bay-zoltan-nonprofit-ltd/baybit-hardware/photos/baybit_photo_2.jpg

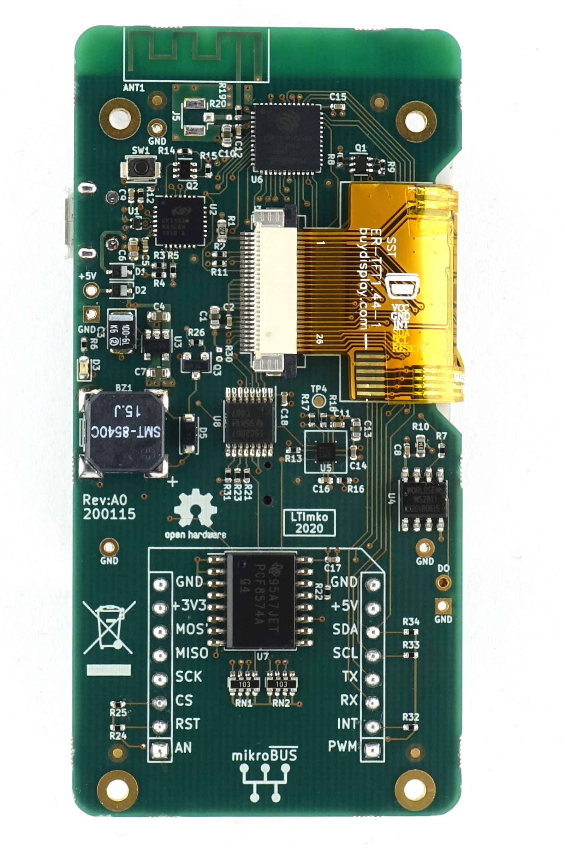
photos/baybit_photo_2.jpg
