bay-zoltan-nonprofit-ltd/baybit-hardware/photos/baybit_photo_1.jpg

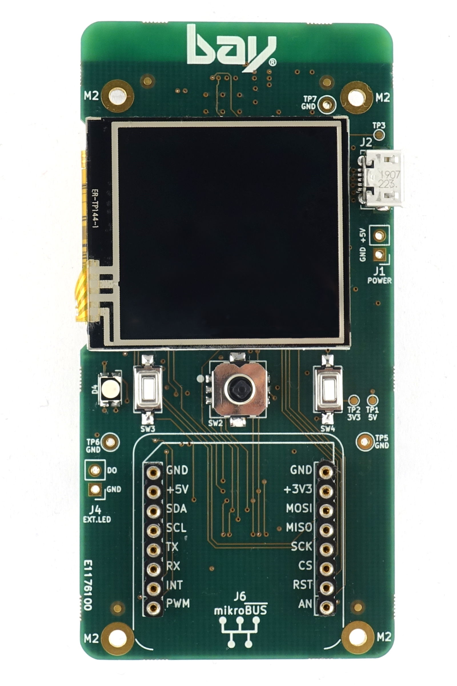
photos/baybit_photo_1.jpg
