bay-zoltan-nonprofit-ltd/baybit-hardware/fab/pcb/readme.txt

PCB Specifications:
  Layers: 4
  Board size: 42 x 85mm
  Board thickness: 1.5mm
  Smallest line width: 0.15mm (6mil)
  Smallest VIA: 0.65mm pad / 0.3mm hole (ipc7351b: v65h30)
  
Layer stack-up:
  LAYER1 - Front - SIGNAL
  LAYER2 - In1 - PLANE
  LAYER3 - In2 - PLANE
  LAYER4 - Back - SIGNAL
