bay-zoltan-nonprofit-ltd/baybit-hardware/photos/baybit_render_3d.jpg

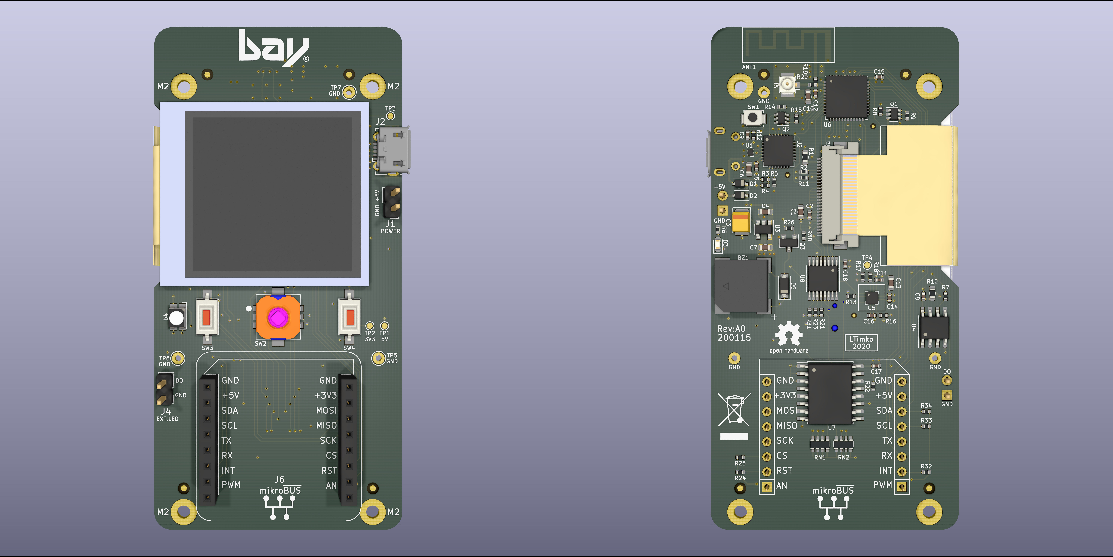
photos/baybit_render_3d.jpg
