bay-zoltan-nonprofit-ltd/baybit-hardware/design/3dmodels/ASMB-MTB0-0A3A2.STEP

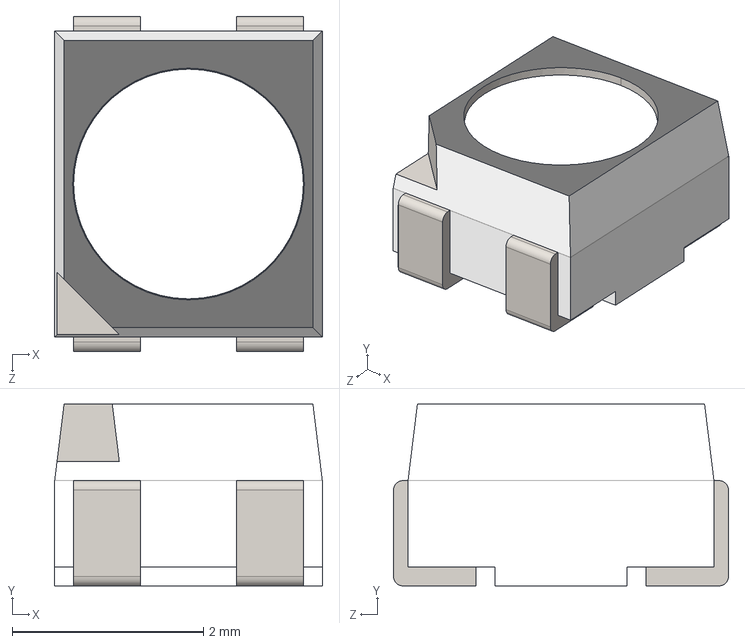
[picture p6: CAD file, 2020-03-06]
design/3dmodels/ASMB-MTB0-0A3A2.STEP
2.80 x 1.90 x 3.50 mm
