bay-zoltan-nonprofit-ltd/baybit-hardware/design/3dmodels/ER-TFT1.44-1.stp

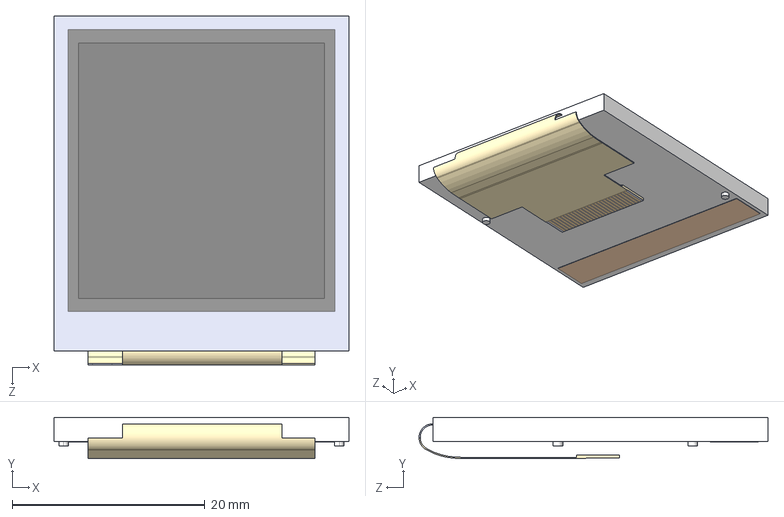
[picture p7: CAD file, 2020-03-06]
design/3dmodels/ER-TFT1.44-1.stp
30.6 x 4.29 x 36.2 mm
