bay-zoltan-nonprofit-ltd/baybit-hardware/design/3dmodels/FH12A-26S-0.5SH.stp

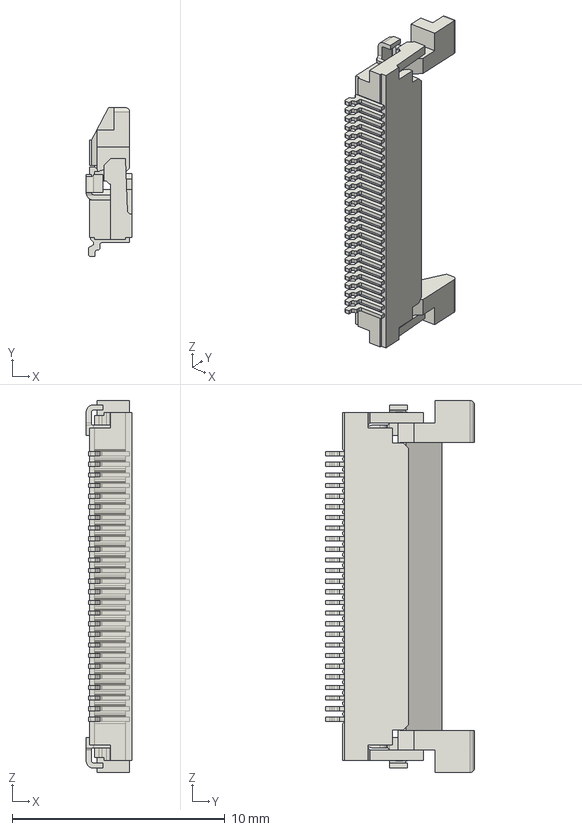
[picture p8: CAD file, 2020-03-06]
design/3dmodels/FH12A-26S-0.5SH.stp
2.15 x 7.00 x 17.5 mm
