bay-zoltan-nonprofit-ltd/baybit-hardware/design/3dmodels/SKRHAB.STEP

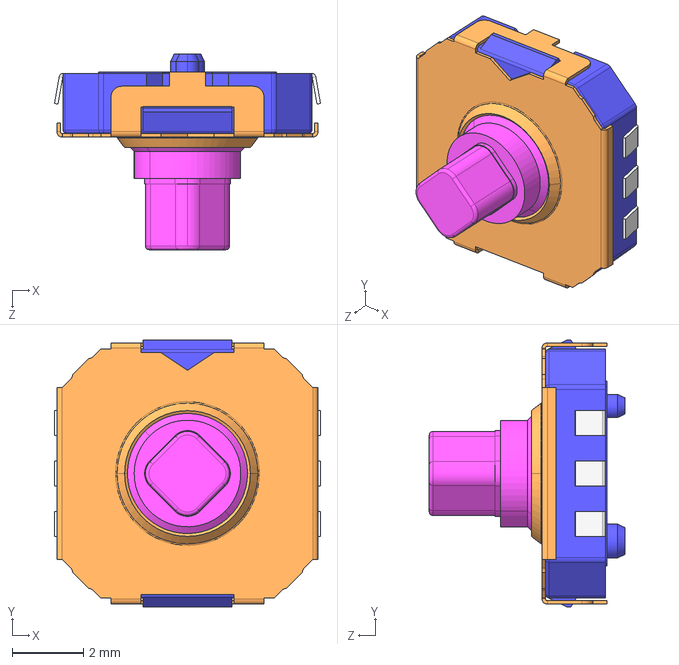
[picture p9: CAD file, 2020-03-06]
design/3dmodels/SKRHAB.STEP
7.48 x 7.50 x 5.50 mm
