bay-zoltan-nonprofit-ltd/baybit-hardware/design/3dmodels/BUZZER_SMT_85X85X32.step

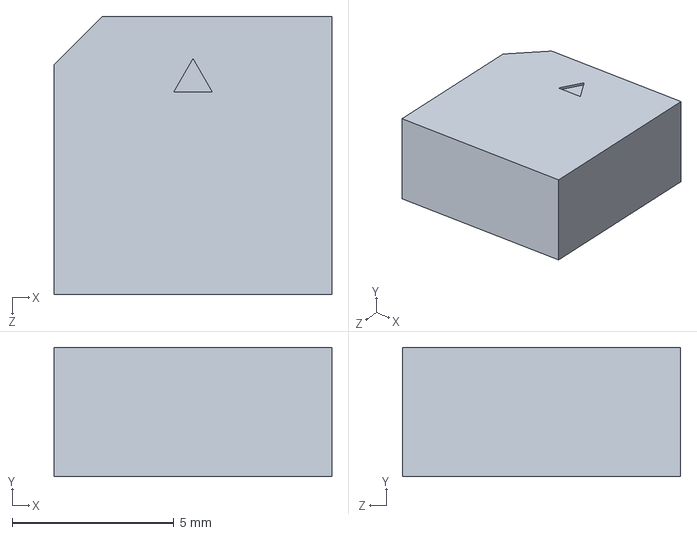
[picture p10: CAD file, 2020-03-06]
design/3dmodels/BUZZER_SMT_85X85X32.step
8.60 x 4.00 x 8.60 mm
