bay-zoltan-nonprofit-ltd/baybit-hardware/design/3dmodels/1050170001.stp

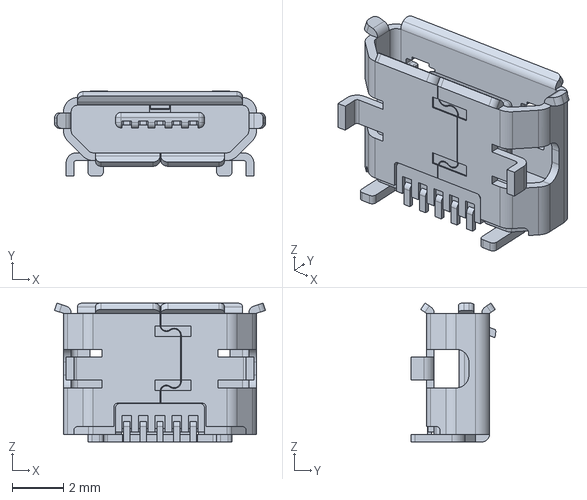
[picture p11: CAD file, 2020-03-06]
design/3dmodels/1050170001.stp
8.20 x 3.30 x 5.40 mm
