bay-zoltan-nonprofit-ltd/baybit-hardware/docs/baybit_schematic.pdf

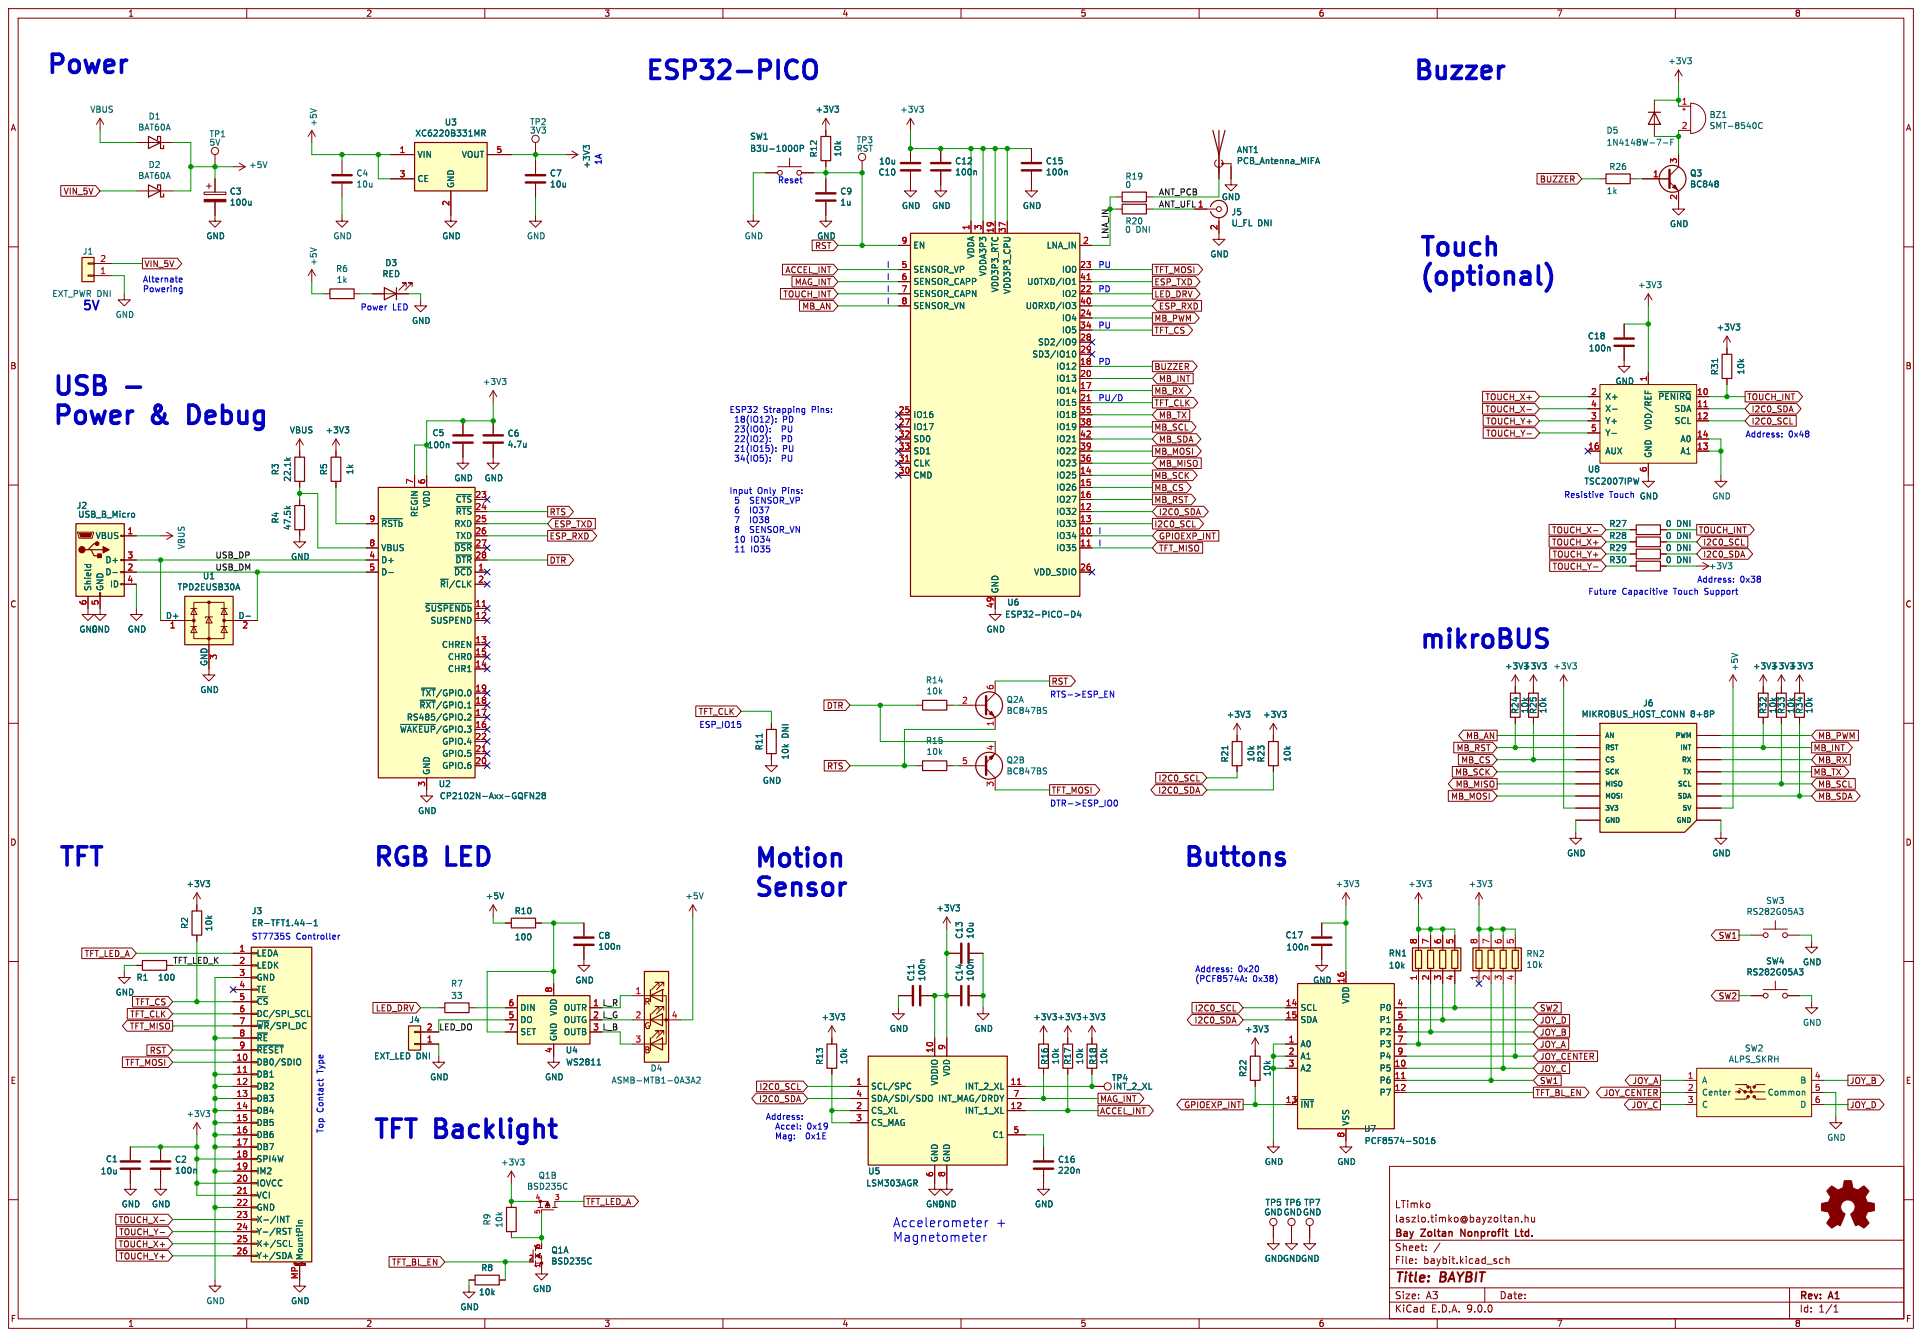
[picture p12: page 1]

4 OUTR 1 OUTG 2 OUTB 3 U4WS2811 GND R12 10k C10

Address: 0x48 PU TFT Backlight

3 ~{CTS} 23 ~{RTS} 24 RXD 25 TXD 26 ~{DSR} 27 ~{DTR} 28 ~{DCD}1 ~{RI}/CLK2 ~{SUSPENDb}11 SUSPEND 12 CHREN 13 CHR0 15 CHR1 14 ~{TXT}/GPIO.019 ~{RXT}/GPIO.118 RS485/GPIO.2 17 ~{WAKEUP}/GPIO.316 GPIO.4 22 GPIO.5 21 GPIO.6 20 C6

3 ~{CTS} 23 ~{RTS} 24 RXD 25 TXD 26 ~{DSR} 27 ~{DTR} 28 ~{DCD}1 ~{RI}/CLK2 ~{SUSPENDb}11 SUSPEND 12 CHREN 13 CHR0 15 CHR1 14 ~{TXT}/GPIO.019 ~{RXT}/GPIO.118 RS485/GPIO.2 17 ~{WAKEUP}/GPIO.316 GPIO.4 22 GPIO.5 21 GPIO.6 20 U2CP2102N-Axx-GQFN28

RTS->ESP_EN Top Contact Type

RST CS
SCK MISO MOSI 3V3 GND

4 OUTR 1 OUTG 2 OUTB 3 GND

laszlo.timko@bayzoltan.hu
