bay-zoltan-nonprofit-ltd/baybit-hardware/fab/assy/baybit_parts.pdf

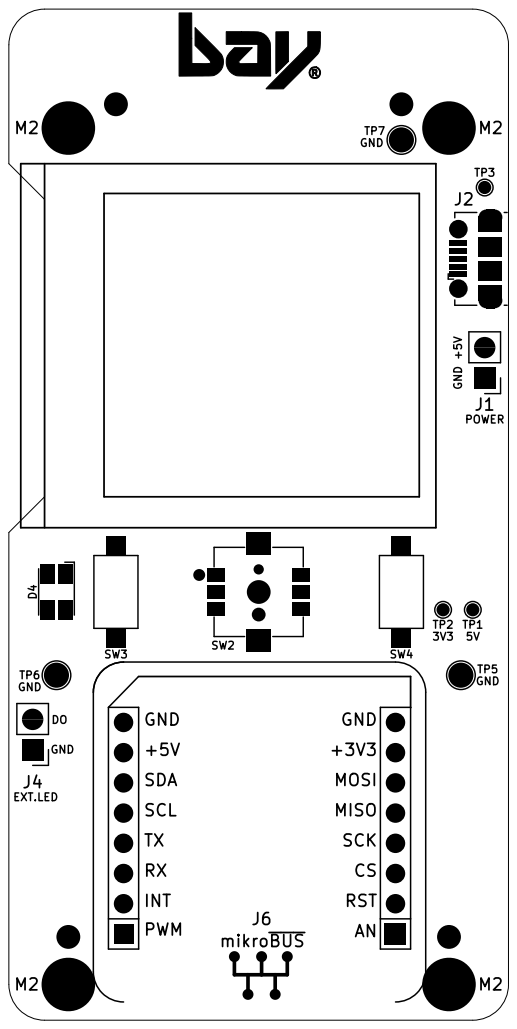
[picture p13: page 1]

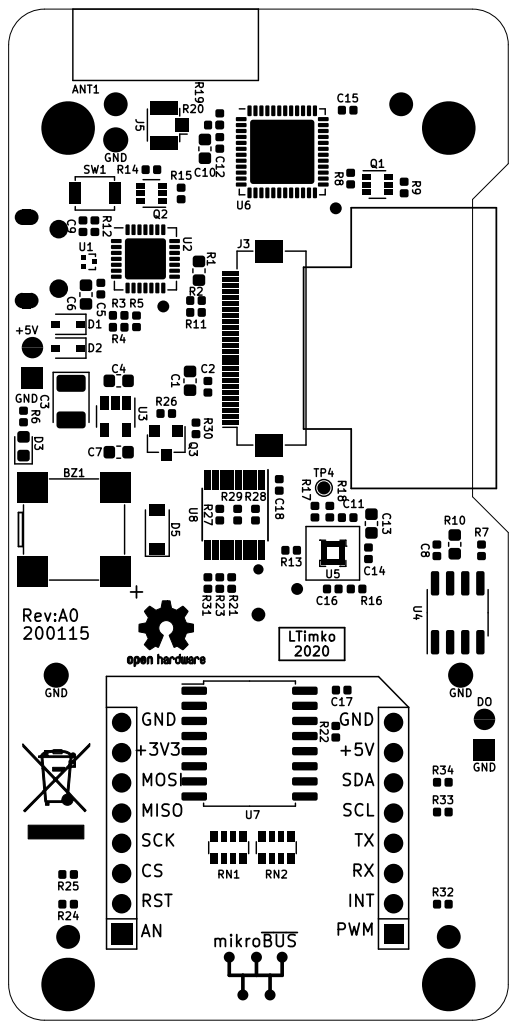
[picture p14: page 2]
