bay-zoltan-nonprofit-ltd/baybit-hardware/fab/assy/baybit_assy.pdf

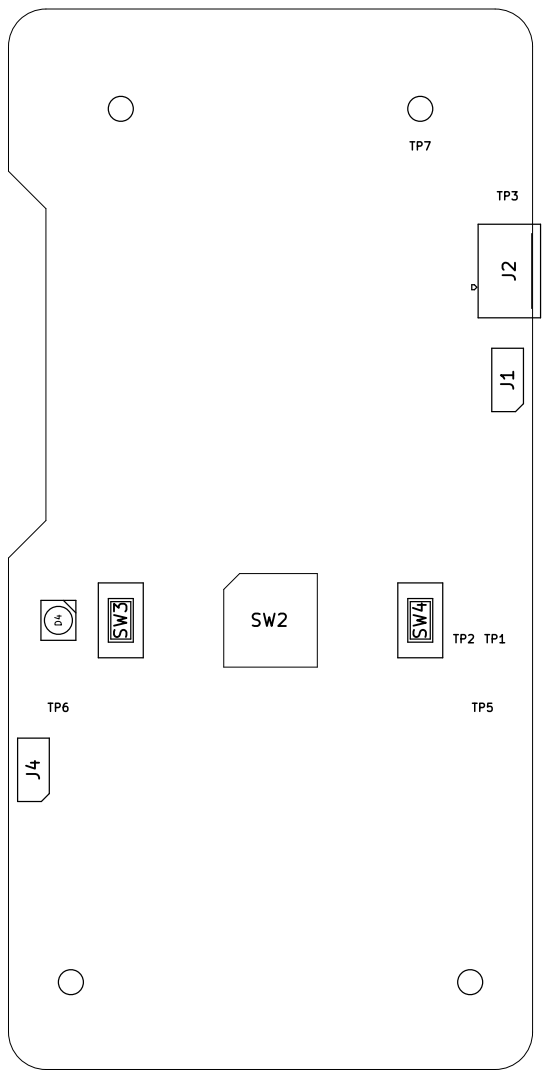
[picture p15: page 1]

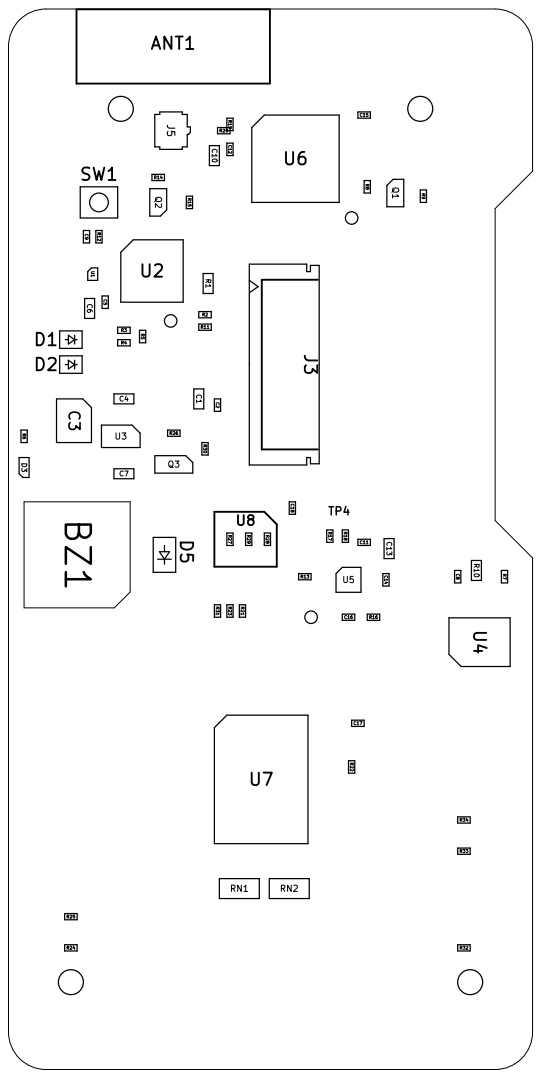
[picture p16: page 2]
