bay-zoltan-nonprofit-ltd/baybit-hardware/fab/assy/baybit_placement.pdf

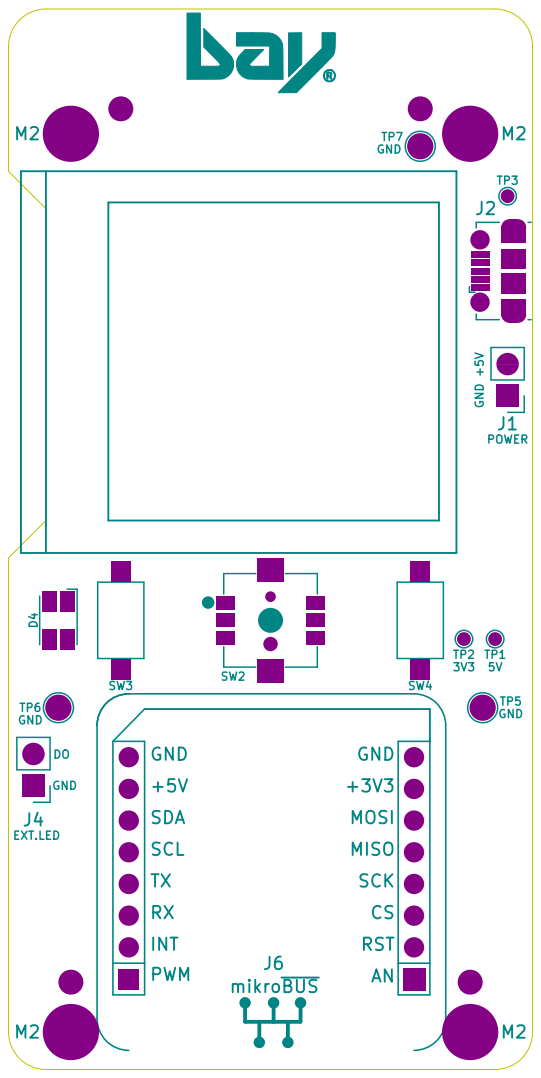
[picture p17: page 1]

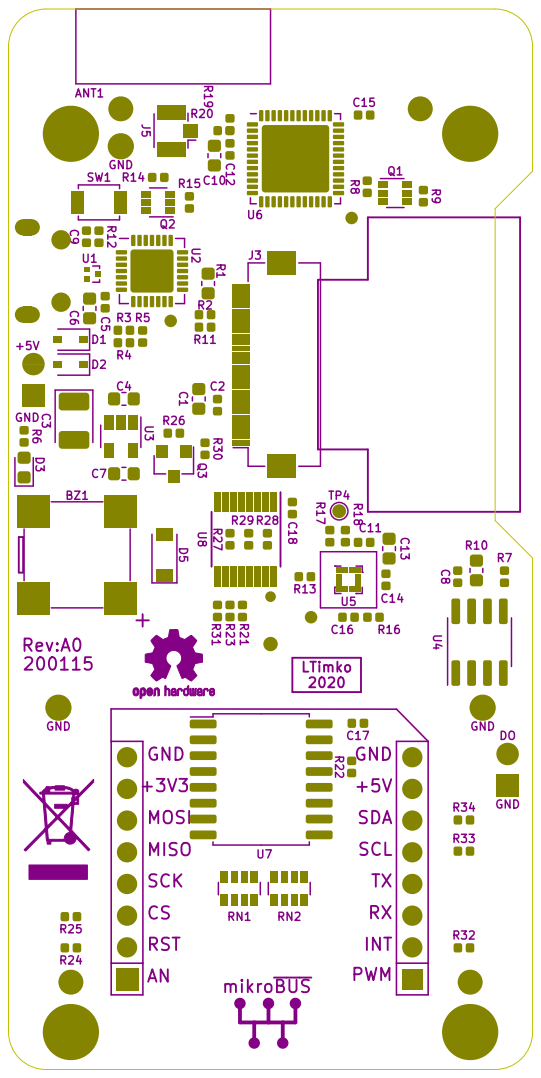
[picture p18: page 2]
