bay-zoltan-nonprofit-ltd/baybit-hardware/design/kicad_project/baybit.kicad_pcb

## KiCad design design/kicad_project/baybit.kicad_pcb (2025-02-21)

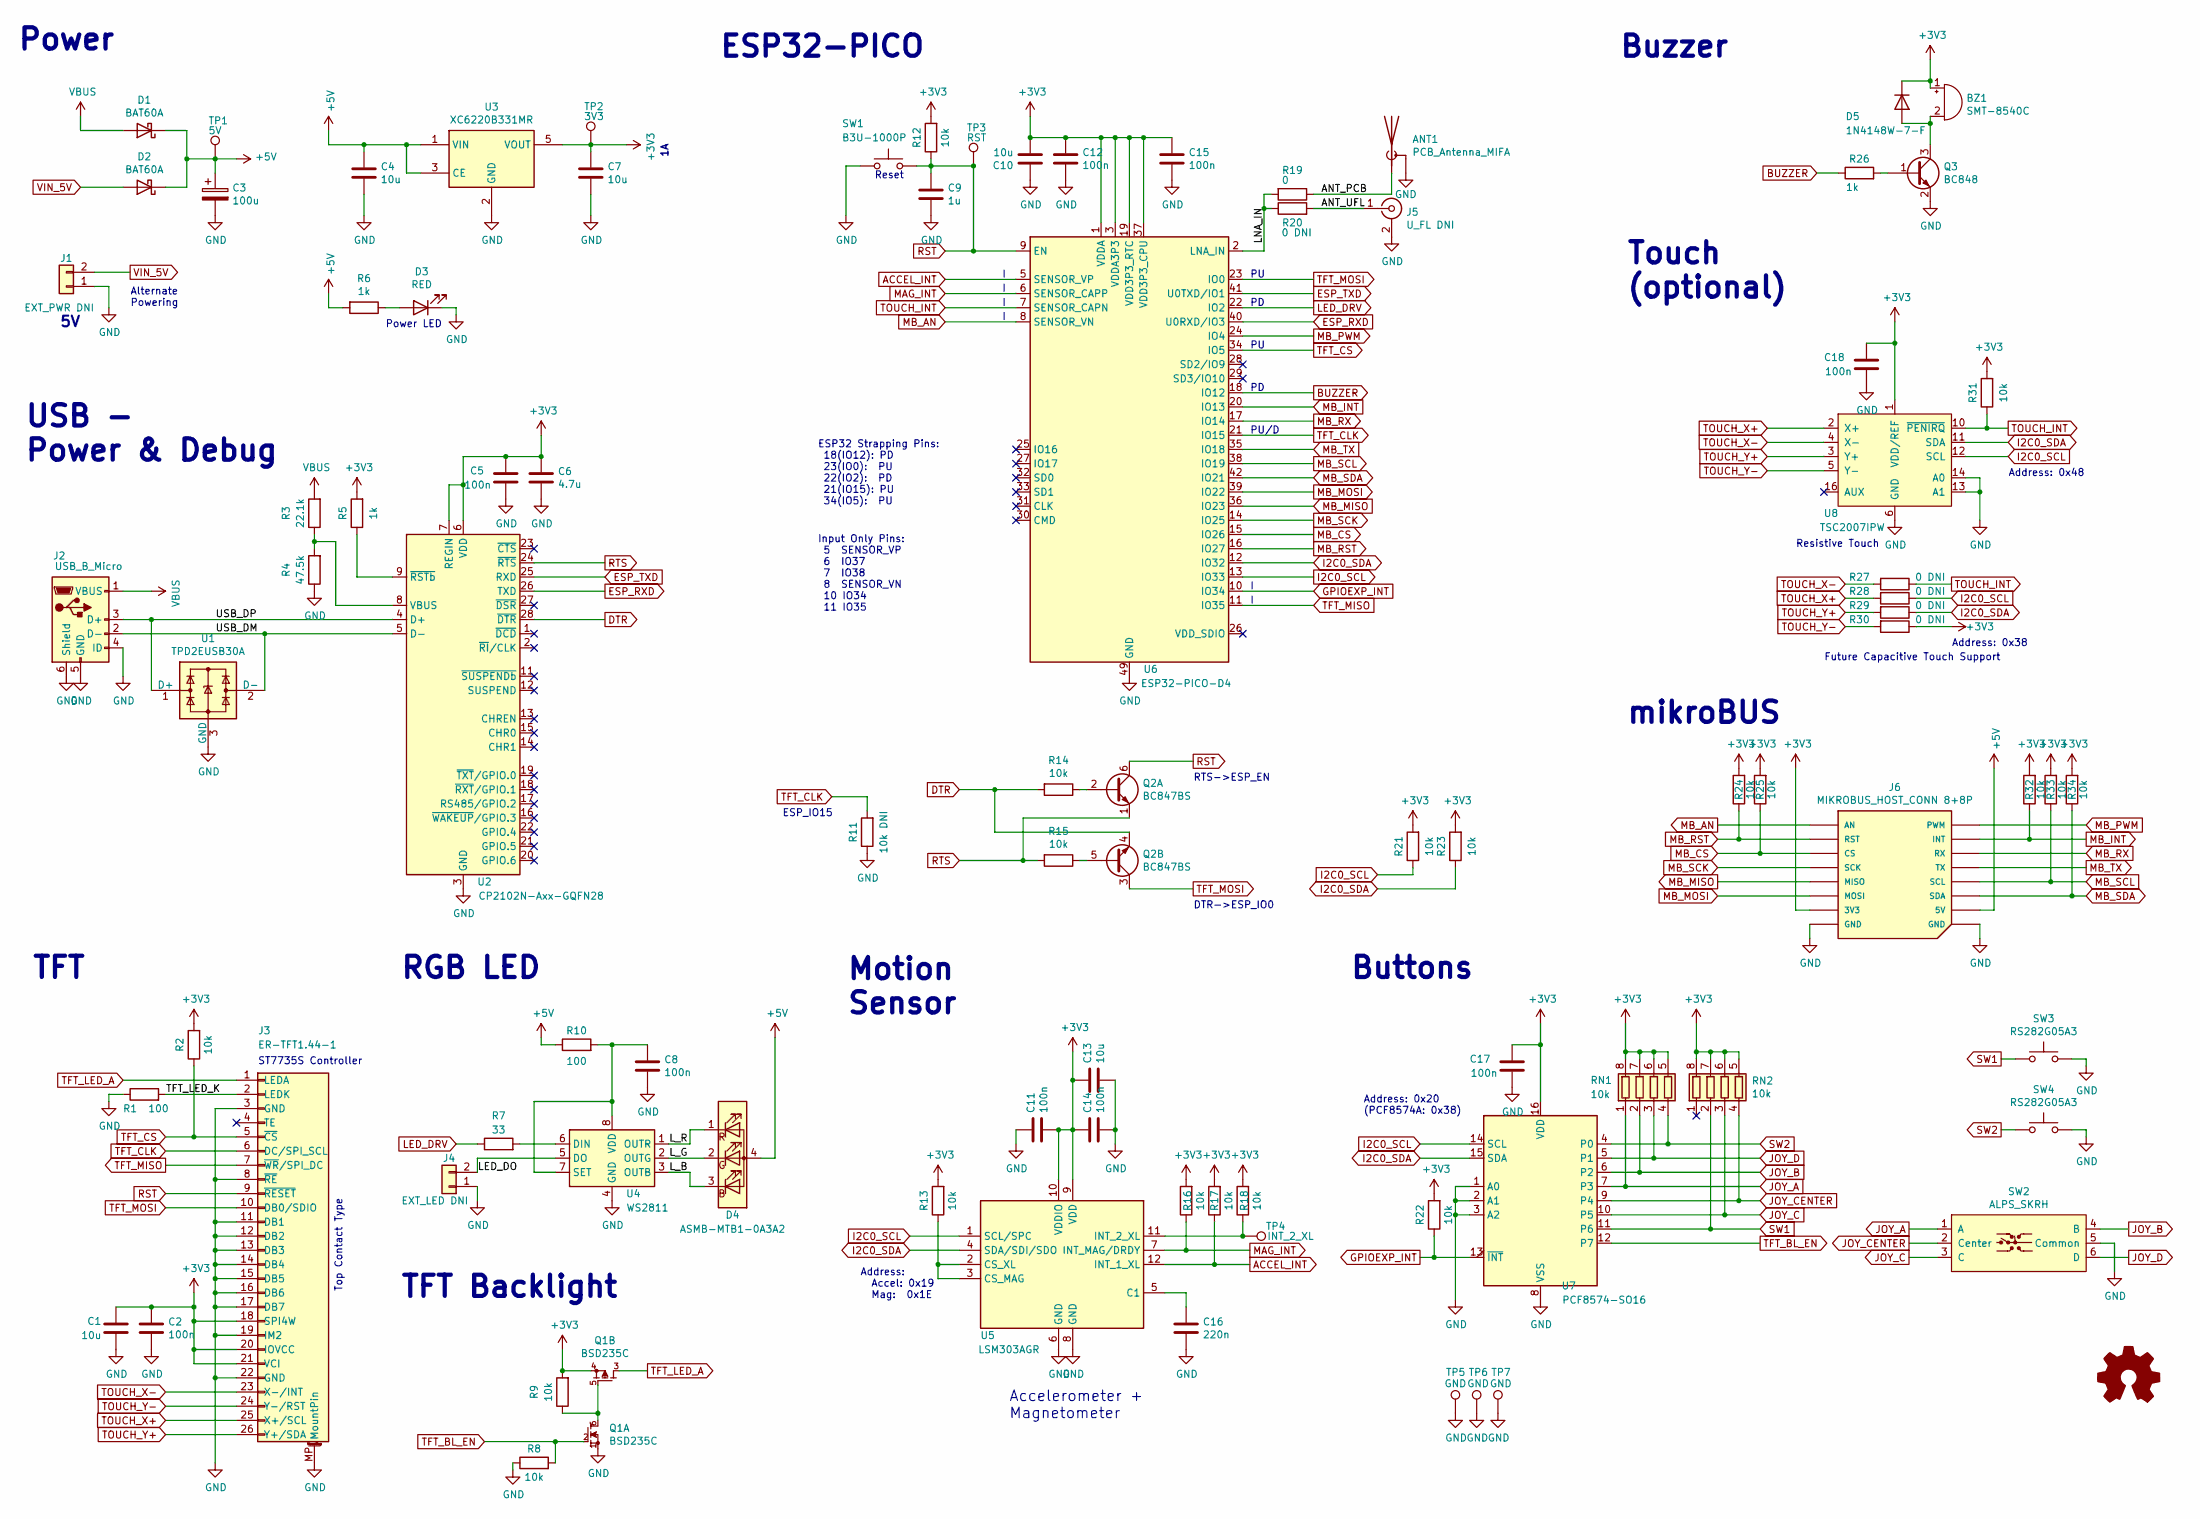
[picture p19: schematic baybit.kicad_sch]

Parts:
ANT1: PCB_Antenna_MIFA; Texas_SWRA117D_2.4GHz_Left
BZ1: SMT-8540C; BUZZER_SMT_85X85X32
C1, C4, C7, C10, C13: 10u; C_0603_1608Metric
C2, C5, C8, C11, C12, C14, C15, C17, C18: 100n; C_0402_1005Metric
C3: 100u; CP_EIA-3528-21_Kemet-B
C6: 4.7u; C_0603_1608Metric
C9: 1u; C_0402_1005Metric
C16: 220n; C_0402_1005Metric
D1, D2: BAT60A; D_SOD-323
D3: RED; LED_0603_1608Metric
D4: ASMB-MTB1-0A3A2; LED_Avago_PLCC4_3.2x2.8mm_CW
D5: 1N4148W-7-F; D_SOD-123
J1: EXT_PWR DNI; PinHeader_1x02_P2.54mm_Vertical
J2: USB_B_Micro; USB_Micro-B_Molex-105017-0001
J3: ER-TFT1.44-1; Hirose_FH12A-26S-0.5SH_1x26-1MP_P0.50mm_Horizontal
J4: EXT_LED DNI; PinHeader_1x02_P2.54mm_Vertical
J5: U_FL DNI; U.FL_Hirose_U.FL-R-SMT-1_Vertical
J6: MIKROBUS_HOST_CONN 8+8P; MIKROBUS_HOST_CONN
Q1: BSD235C; SOT-363_SC-70-6
Q2: BC847BS; SOT-363_SC-70-6
Q3: BC848; SOT-23
R1, R10: 100; R_0603_1608Metric
R2, R8, R9, R12, R13, R14, R15, R16, R17, R18, R21, R22, R23, R24, R25, R31, R32, R33, R34: 10k; R_0402_1005Metric
R3: 22.1k; R_0402_1005Metric
R4: 47.5k; R_0402_1005Metric
R5, R6, R26: 1k; R_0402_1005Metric
R7: 33; R_0402_1005Metric
R11: 10k DNI; R_0402_1005Metric
R19: 0; R_0402_1005Metric
R20, R27, R28, R29, R30: 0 DNI; R_0402_1005Metric
RN1, RN2: 10k; R_Array_Convex_4x0603
SW1: B3U-1000P; SW_SPST_B3U-1000P
SW2: ALPS_SKRH
SW3, SW4: RS282G05A3; SW_SPST_CK_RS282G05A3
TP1: 5V; TestPoint_Pad_D1.0mm
TP2: 3V3; TestPoint_Pad_D1.0mm
TP3: RST; TestPoint_Pad_D1.0mm
TP4: INT_2_XL; TestPoint_Pad_D1.0mm
TP5, TP6, TP7: GND; TestPoint_THTPad_D2.0mm_Drill1.0mm
U1: TPD2EUSB30A; Texas_DRT-3
U2: CP2102N-Axx-GQFN28; QFN-28-1EP_5x5mm_P0.5mm_EP3.35x3.35mm
U3: XC6220B331MR; SOT-23-5
U4: WS2811; SOIC-8_3.9x4.9mm_P1.27mm
U5: LSM303AGR; LGA-12_2x2mm_P0.5mm
U6: ESP32-PICO-D4; QFN-48-1EP_7x7mm_P0.5mm_EP5.15x5.15mm
U7: PCF8574-SO16; SOIC-16W_7.5x10.3mm_P1.27mm
U8: TSC2007IPW; TSSOP-16_4.4x5mm_P0.65mm

Connections:
+3V3: BZ1.1 (-), C1.2, C2.1, C5.2, C6.1, C7.1, C10.2, C11.2, C12.1, C13.1, C14.1, C15.1, C17.2, C18.2, D5.1 (K), J3.18 (SPI4W), J3.20 (IOVCC), J3.21 (VCI), J6.P7 (3V3), Q1.4 (S), R2.2, R5.2, R9.2, R12.2, R13.2, R16.2, R17.2, R18.2, R21.2, R22.2, R23.2, R24.2, R25.2, R30.1, R31.2, R32.2, R33.2, R34.2, RN1.5 (R4.2), RN1.6 (R3.2), RN1.7 (R2.2), RN1.8 (R1.2), RN2.5 (R4.2), RN2.6 (R3.2), RN2.7 (R2.2), RN2.8 (R1.2), TP2.1, U2.6 (VDD), U2.7 (REGIN), U3.5 (VOUT), U5.9 (VDD), U5.10 (VDDIO), U6.1 (VDDA), U6.3 (VDDA3P3), U6.4 (VDDA3P3), U6.19 (VDD3P3_RTC), U6.37 (VDD3P3_CPU), U6.43 (VDDA), U6.46 (VDDA), U7.16 (VDD), U8.1 (VDD/REF); also elsewhere on the board
+5V: C3.1, C4.1, D1.1 (K), D2.1 (K), D4.4 (A), J6.P10 (5V), R6.2, R10.1, TP1.1, U3.1 (VIN), U3.3 (CE)
/ANT_PCB: ANT1.1 (A), R19.1
/ANT_UFL: J5.1 (In), R20.2
/LED_DO: J4.2, U4.5 (DO)
/LNA_IN: R19.2, R20.1, U6.2 (LNA_IN)
/L_B: D4.3 (BK), U4.3 (OUTB)
/L_G: D4.2 (GK), U4.2 (OUTG)
/L_R: D4.1 (RK), U4.1 (OUTR)
/TFT_LED_K: J3.2 (LEDK), R1.2
/USB_DM: J2.2 (D-), U1.2 (D-), U2.5 (D-)
/USB_DP: J2.3 (D+), U1.1 (D+), U2.4 (D+)
ACCEL_INT: R17.1, U5.12 (INT_1_XL), U6.5 (SENSOR_VP)
BUZZER: R26.1, U6.18 (IO12)
DTR: Q2.4 (E2), R14.2, U2.28 (~DTR)
ESP_RXD: U2.26 (TXD), U6.40 (U0RXD/IO3)
ESP_TXD: U2.25 (RXD), U6.41 (U0TXD/IO1)
GND: ANT1.2 (Shield), C1.1, C2.2, C3.2, C4.2, C5.1, C6.2, C7.2, C8.2, C9.2, C10.1, C11.1, C12.2, C13.2, C14.2, C15.2, C16.2, C17.1, C18.1, D3.1 (K), J1.1, J2.4 (ID), J2.5 (GND), J2.6 (Shield), J3.3 (GND), J3.8 (~RE), J3.11 (DB1), J3.12 (DB2), J3.13 (DB3), J3.14 (DB4), J3.15 (DB5), J3.16 (DB6), J3.17 (DB7), J3.19 (IM2), J3.22 (GND), J3.MP (MountPin), J4.1, J5.2 (Ext), J6.P8 (GND), J6.P9 (GND), Q1.1 (S), Q3.2 (E), R1.1, R4.1, R8.1, R11.1, SW1.1, SW2.5 (Common), SW3.2, SW4.2, TP5.1, TP6.1, TP7.1, U1.3 (GND), U2.3 (GND), U2.29 (GND), U3.2 (GND), U4.4 (GND), U5.6 (GND), U5.8 (GND), U6.49 (GND), U7.1 (A0), U7.2 (A1), U7.3 (A2), U7.8 (VSS), U8.6 (GND), U8.13 (A1), U8.14 (A0)
GPIOEXP_INT: R22.1, U6.10 (IO34), U7.13 (~INT)
I2C0_SCL: R21.1, R28.1, U5.1 (SCL/SPC), U6.13 (IO33), U7.14 (SCL), U8.12 (SCL)
I2C0_SDA: R23.1, R29.1, U5.4 (SDA/SDI/SDO), U6.12 (IO32), U7.15 (SDA), U8.11 (SDA)
JOY_A: RN1.1 (R1.1), SW2.1 (A), U7.7 (P3)
JOY_B: RN1.2 (R2.1), SW2.4 (B), U7.6 (P2)
JOY_C: RN2.3 (R3.1), SW2.3 (C), U7.10 (P5)
JOY_CENTER: RN2.4 (R4.1), SW2.2 (Center), U7.9 (P4)
JOY_D: RN1.3 (R3.1), SW2.6 (D), U7.5 (P1)
LED_DRV: R7.1, U6.22 (IO2)
MAG_INT: R16.1, U5.7 (INT_MAG/DRDY), U6.6 (SENSOR_CAPP)
MB_AN: J6.P1 (AN), U6.8 (SENSOR_VN)
MB_CS: J6.P3 (CS), R25.1, U6.15 (IO26)
MB_INT: J6.P15 (INT), R32.1, U6.20 (IO13)
MB_MISO: J6.P5 (MISO), U6.36 (IO23)
MB_MOSI: J6.P6 (MOSI), U6.39 (IO22)
MB_PWM: J6.P16 (PWM), U6.24 (IO4)
MB_RST: J6.P2 (RST), R24.1, U6.16 (IO27)
MB_RX: J6.P14 (RX), U6.17 (IO14)
MB_SCK: J6.P4 (SCK), U6.14 (IO25)
MB_SCL: J6.P12 (SCL), R33.1, U6.38 (IO19)
MB_SDA: J6.P11 (SDA), R34.1, U6.42 (IO21)
MB_TX: J6.P13 (TX), U6.35 (IO18)
unnamed: BZ1.2 (+), D5.2 (A), Q3.3 (C)
unnamed: D3.2 (A), R6.1
unnamed: Q1.5 (G), Q1.6 (D), R9.1
unnamed: Q2.2 (B1), R14.1
unnamed: Q2.5 (B2), R15.1
unnamed: Q3.1 (B), R26.2
unnamed: R3.1, R4.2, U2.8 (VBUS)
unnamed: R5.1, U2.9 (~RSTb)
unnamed: R7.2, U4.6 (DIN)
unnamed: C8.1, R10.2, U4.7 (SET), U4.8 (VDD)
unnamed: C16.1, U5.5 (C1)
unnamed: R13.1, U5.2 (CS_XL), U5.3 (CS_MAG)
unnamed: R18.1, TP4.1, U5.11 (INT_2_XL)
RST: C9.1, J3.9 (~RESET), Q2.6 (C1), R12.1, SW1.2, TP3.1, U6.9 (EN)
RTS: Q2.1 (E1), R15.2, U2.24 (~RTS)
SW1: RN2.2 (R2.1), SW3.1, U7.11 (P6)
SW2: RN1.4 (R4.1), SW4.1, U7.4 (P0)
TFT_BL_EN: Q1.2 (G), R8.2, U7.12 (P7)
TFT_CLK: J3.6 (DC/SPI_SCL), R11.2, U6.21 (IO15)
TFT_CS: J3.5 (~CS), R2.1, U6.34 (IO5)
TFT_LED_A: J3.1 (LEDA), Q1.3 (D)
TFT_MISO: J3.7 (~WR/SPI_DC), U6.11 (IO35)
TFT_MOSI: J3.10 (DB0/SDIO), Q2.3 (C2), U6.23 (IO0); also elsewhere on the board
TOUCH_INT: R27.1, R31.1, U6.7 (SENSOR_CAPN), U8.10 (~PENIRQ)
TOUCH_X+: J3.25 (X+/SCL), R28.2, U8.2 (X+)
TOUCH_X-: J3.23 (X-/INT), R27.2, U8.4 (X-)
TOUCH_Y+: J3.26 (Y+/SDA), R29.2, U8.3 (Y+)
TOUCH_Y-: J3.24 (Y-/RST), R30.2, U8.5 (Y-)
VBUS: D1.2 (A), J2.1 (VBUS), R3.2
VIN_5V: D2.2 (A), J1.2

Notes on the sheet:
ESP32 Strapping Pins: 18(IO12): PD 23(IO0): PU 22(IO2): PD 21(IO15): PU 34(IO5): PU
Touch (optional)
Future Capacitive Touch Support
Address: 0x20 (PCF8574A: 0x38)
Buttons
Buzzer
RTS->ESP_EN
ESP32-PICO
Input Only Pins: 5 SENSOR_VP 6 IO37 7 IO38 8 SENSOR_VN 10 IO34 11 IO35
Address: Accel: 0x19 Mag: 0x1E
USB - Power & Debug
TFT Backlight
TFT
Power
Reset
PU/D
Address: 0x38
Alternate Powering
ST7735S Controller
mikroBUS
RGB LED
Motion Sensor
Resistive Touch
Power LED
Top Contact Type
ESP_IO15
Accelerometer + Magnetometer
DTR->ESP_IO0
Address: 0x48

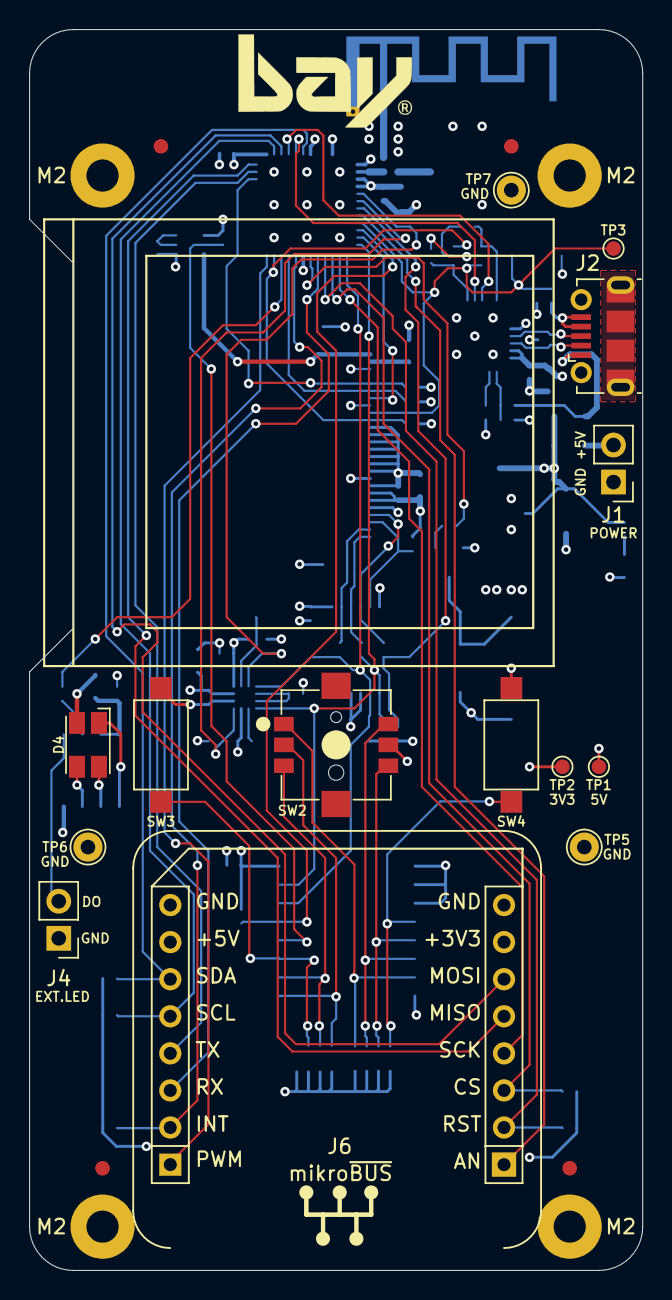
[picture p20: board baybit.kicad_pcb from above]

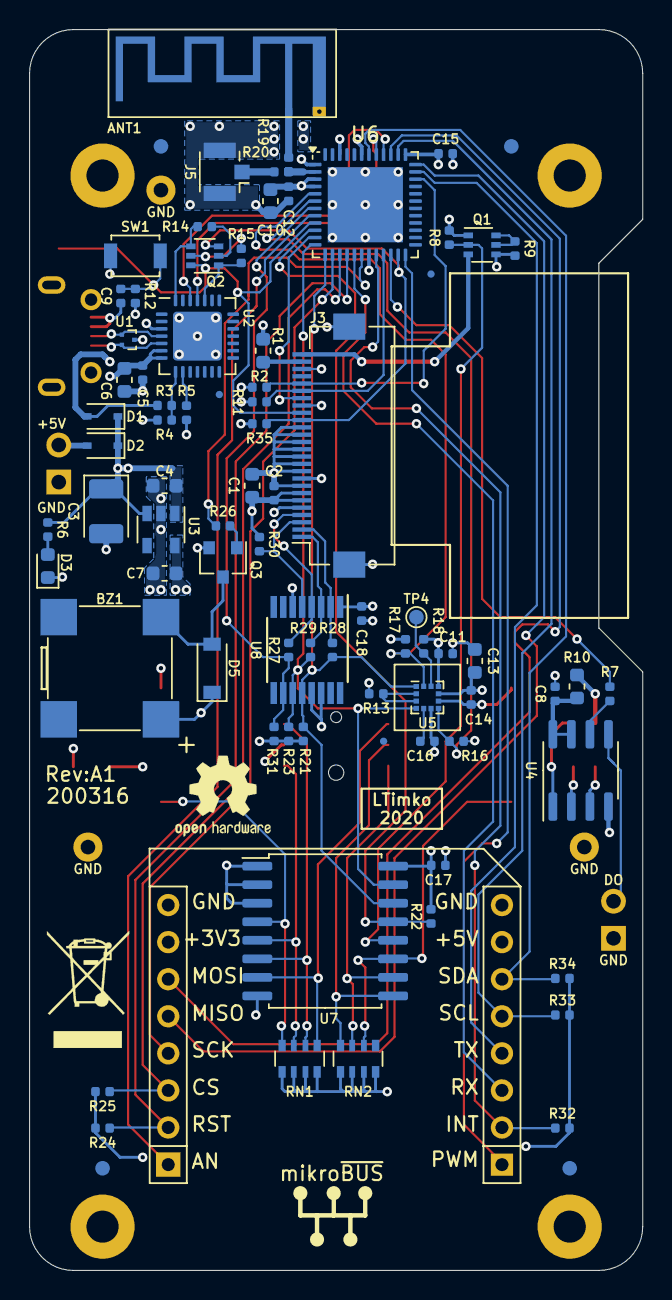
[picture p21: board baybit.kicad_pcb from below]

Board: 4 copper layers, 42.0 x 85.0 mm, 90 parts (76 on the bottom side), 70 nets.

Other parts of the board:
R35: 10k; R_0402_1005Metric

Their connections:
+3V3: R35.2; also elsewhere on the board
TFT_MOSI: R35.1; also elsewhere on the board
