bay-zoltan-nonprofit-ltd/baybit-hardware/(commit log)

2020-03-06 Import project
    [1050170001.stp, ASMB-MTB0-0A3A2.STEP, BUZZER_SMT_85X85X32.step, ER-TFT1.44-1.stp, FH12A-26S-0.5SH.stp, SKRHAB.STEP, baybit.kicad_pcb, baybit.sch]
2022-01-05 Migrated to Kicad 6
    [baybit.kicad_pcb, baybit.kicad_sch, baybit.sch]
2025-02-21 Migrated to Kicad 9
    [baybit.kicad_pcb, baybit.kicad_sch]
